PeachyPrinter/peachyprinterhardware1.0/README.md

# peachyprinterhardware1.0

All laser cut parts used in the $100 peachy printer kit

File types:

	- *.scad design files (OpenScad) 

	- *.dxf exported vector file 

	- *.smc after modified for lasercutting (SmartCarve)
