PeachyPrinter/peachyprinterhardware1.0/coil_circuit_jig.dxf

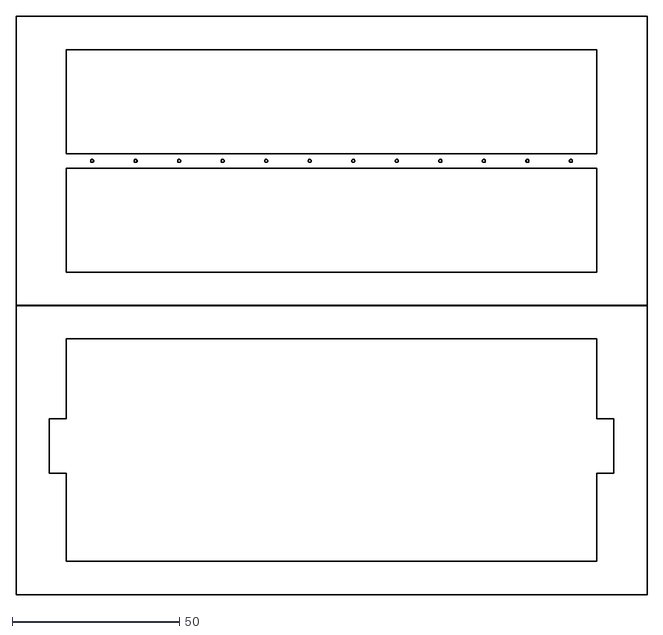
[picture p1: CAD file, 2015-10-30]
coil_circuit_jig.dxf
188.5 x 172.7
