PeachyPrinter/peachyprinterhardware1.0/tools/snaps.dxf

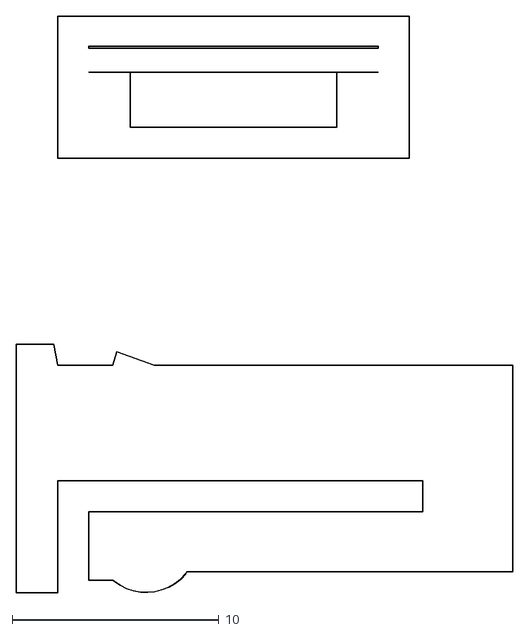
[picture p2: CAD file, 2015-04-24]
tools/snaps.dxf
24.0 x 27.9
