PeachyPrinter/peachyprinterhardware1.0/parts/hosePlug.dxf

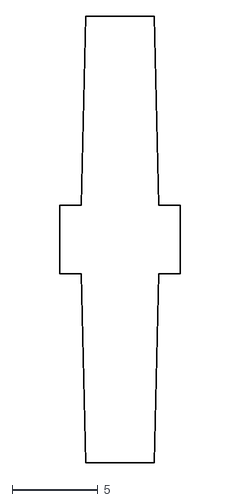
[picture p3: CAD file, 2015-12-13]
parts/hosePlug.dxf
7.00 x 26.0
