PeachyPrinter/peachyprinterhardware1.0/parts/hose_clamp.dxf

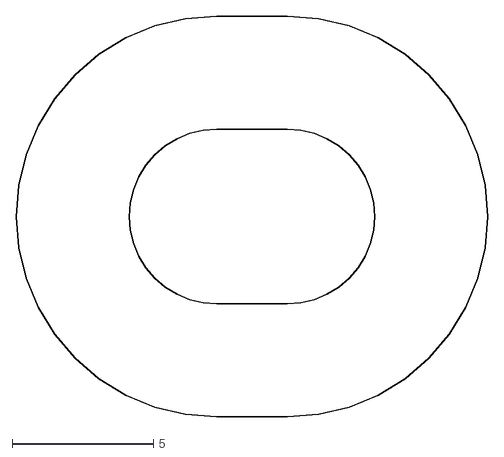
[picture p4: CAD file, 2015-12-13]
parts/hose_clamp.dxf
16.7 x 14.2
