PeachyPrinter/peachyprinterhardware1.0/parts/peachyScanner.dxf

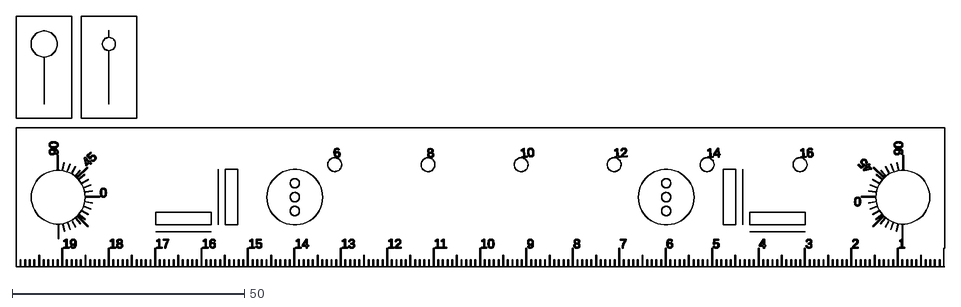
[picture p5: CAD file, 2015-12-05]
parts/peachyScanner.dxf
200.0 x 54.0
