PeachyPrinter/peachyprinterhardware1.0/parts/frame.dxf

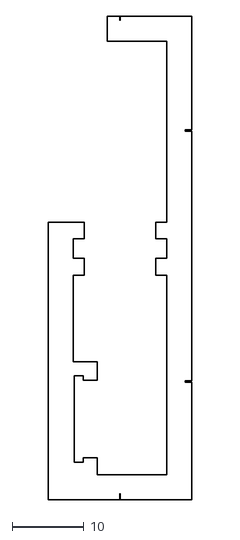
[picture p6: CAD file, 2015-10-30]
parts/frame.dxf
20.0 x 67.5
