PeachyPrinter/peachyprinterhardware1.0/parts/magnifying_glass_easter_egg.dxf

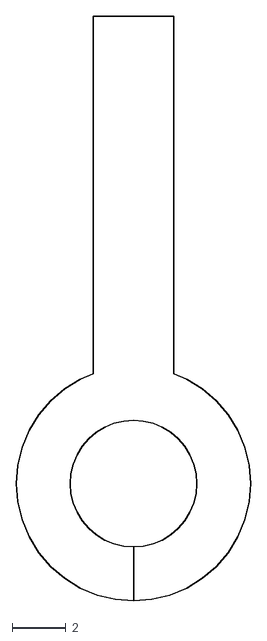
[picture p7: CAD file, 2015-10-30]
parts/magnifying_glass_easter_egg.dxf
8.70 x 21.7
