PeachyPrinter/peachyprinterhardware1.0/parts/mirror_easter_egg.dxf

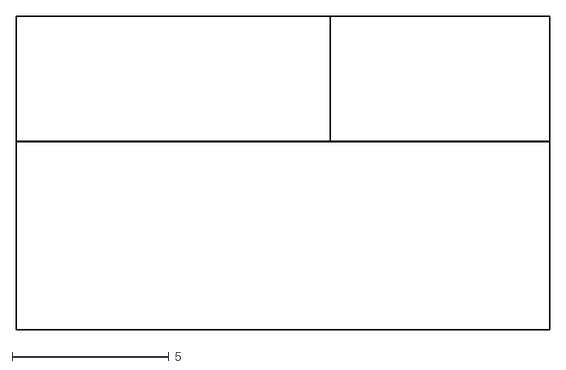
[picture p8: CAD file, 2015-10-14]
parts/mirror_easter_egg.dxf
17.0 x 10.0
