PeachyPrinter/peachyprinterhardware1.0/parts/galvo.dxf

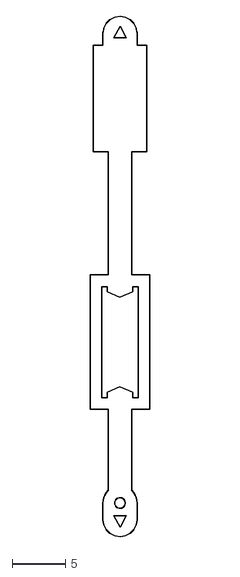
[picture p9: CAD file, 2015-09-26]
parts/galvo.dxf
5.60 x 48.8
