PeachyPrinter/peachyprinterhardware1.0/parts/circuitBrace2.dxf

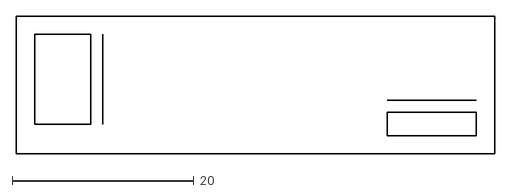
[picture p10: CAD file, 2015-08-28]
parts/circuitBrace2.dxf
52.7 x 15.2
