PeachyPrinter/peachyprinterhardware1.0/parts/circuitHolder.dxf

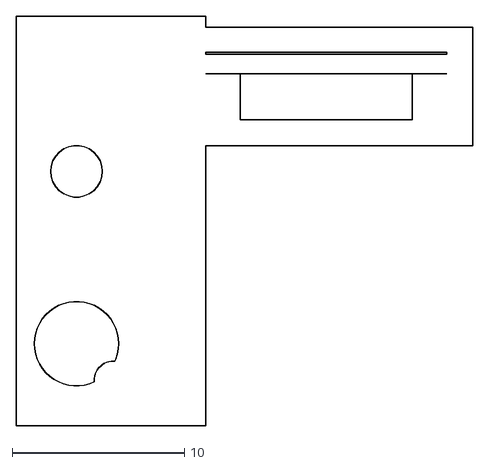
[picture p11: CAD file, 2015-08-28]
parts/circuitHolder.dxf
26.5 x 23.8
