PeachyPrinter/peachyprinterhardware1.0/parts/mirror.dxf

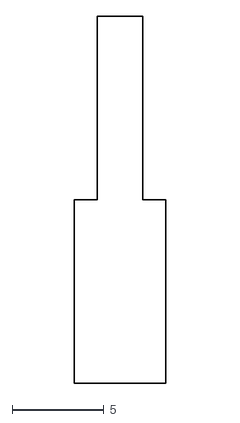
[picture p12: CAD file, 2015-08-11]
parts/mirror.dxf
5.00 x 20.0
