PeachyPrinter/peachyprinterhardware1.0/parts/circuitBrace.dxf

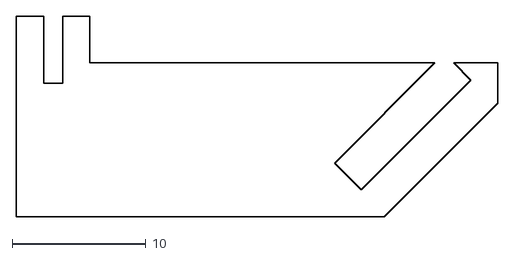
[picture p13: CAD file, 2015-07-31]
parts/circuitBrace.dxf
36.0 x 15.0
