PeachyPrinter/peachyprinterhardware1.0/parts/box.dxf

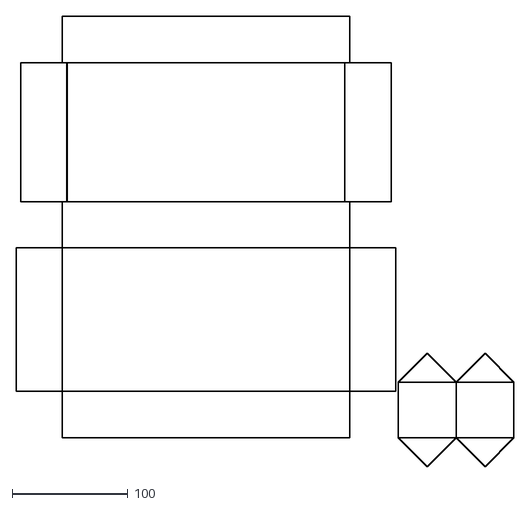
[picture p14: CAD file, 2015-06-11]
parts/box.dxf
430.0 x 389.0
