PeachyPrinter/peachyprinterhardware1.0/parts/magnetRing.dxf

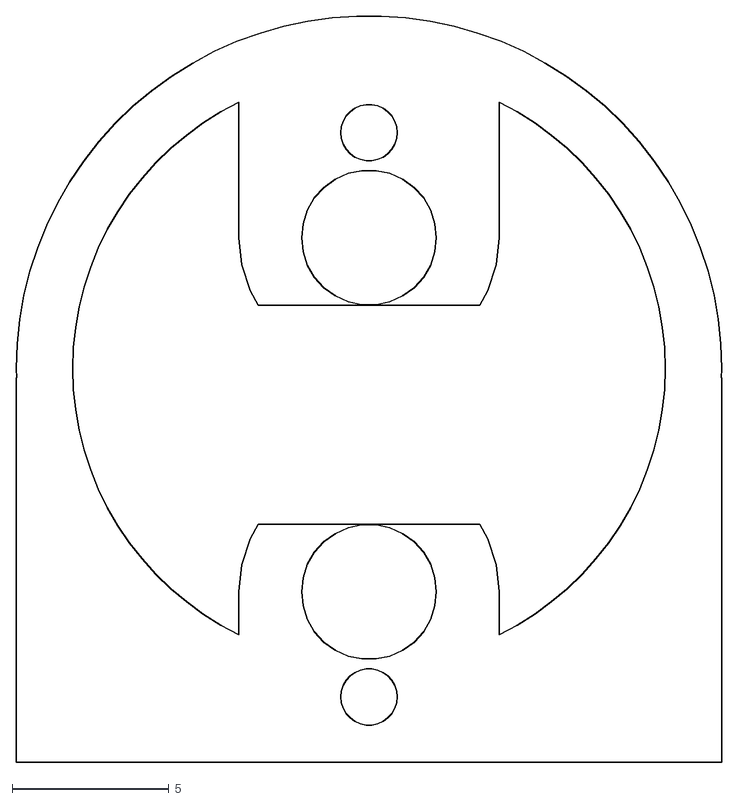
[picture p15: CAD file, 2015-05-21]
parts/magnetRing.dxf
22.5 x 23.8
