PeachyPrinter/peachyprinterhardware1.0/parts/hose_clamp.scad

dy=-.5;
dx=+.5;

r=7.2/2+dy;
d=1-dy*2+dx;
t=4;
$fn=40;

difference(){
    hoop(r+t,d);
    hoop(r,d);
}


module hoop(s,x){
    translate([-x/2,0]) circle(s);
    translate([-x/2,-s]) square([x,s*2]);
    translate([x/2,0]) circle(s);
    
}
