PeachyPrinter/peachyprinterhardware1.0/parts/magnifying_glass_easter_egg.scad

d=4.6;
r=d/2;
th=2;
t=0.01;
$fn=40;

handle=[3,15];

difference(){
    circle(r+th);
    circle(r);
    translate([0,-r-th])square([t,th]);
}
translate([-handle[0]/2,r]) square(handle);
