PeachyPrinter/peachyprinterhardware1.0/(list of files, cad)

Other CAD files:
tools/snaps.scad
parts/circuit brace.dxf
parts/old-parts.scad
