PeachyPrinter/peachyprinterhardware1.0/(commit log)

2015-04-24 current files
    [circuit brace.dxf, circuit brace.scad, circuitHolder.dxf, circuitHolder.scad, frame.dxf, frame.scad, galvo.dxf, galvo.scad]
2015-04-24 linked file
    [circuitHolder.scad]
2015-04-29 added drip sensor to parts
    [drip-sensor.dxf, drip-sensor.scad]
2015-04-29 test cut 1 - 2:10 each
2015-04-29 ziptie holes
2015-05-05 openscad tool for making lines
    workaround for making paths (normally unavailable in openscad)
    makes very thin triangles
    [line.scad]
2015-05-21 rounded acetate arrow edges
    magnet/thread hole corners were interfering with rotation, so made
    rounded edges
    [galvo.dxf, galvo.scad]
2015-05-21 made magnetRing 0.2mm tighter to frame
    there was not enough friction holding magnetRing in place, so made it
    tighter
    [magnetRing.dxf, magnetRing.scad]
2015-05-21 moved coil away
    coil was too close and rubbing so moved away 0.5mm
    [frame.dxf, frame.scad]
2015-05-21 shortened coil holders
    [frame.dxf, frame.scad]
2015-05-27 extra brace for circuit by usb connection
    [circuitBrace.scad, circuitBrace2.dxf, circuitBrace2.scad]
2015-05-31 larger source hose
    [drip-sensor.scad]
2015-06-01 source hose even larger
    [drip-sensor.scad]
2015-06-11 re-parameterized box
    [box.dxf, box.scad]
2015-07-30 allowed for burr on aluminum edges
    [galvo.scad]
2015-07-30 moved back circuit mount on T
    (for laser mount modification) (not changed on parts plate yet)
2015-07-31 made circuit braces work with new circuit position
    [circuitBrace.dxf, circuitBrace.scad, circuitBrace2.dxf, circuitBrace2.scad]
2015-07-31 sized to fit hand shaped aluminum piece
    [galvo.dxf, galvo.scad]
2015-08-11 triangle aluminum rod holder
    [galvo.dxf, galvo.scad]
2015-08-11 mirror with scratchable area
    [mirror.dxf, mirror.scad]
2015-08-11 larger scratch area
    [mirror.dxf, mirror.scad]
2015-08-11 strengthen dripper
    using wider hose -> dripper can be larger
    [drip-sensor.dxf, drip-sensor.scad]
2015-08-11 even thicker
    [drip-sensor.scad]
2015-08-11 wallthickness bug
    [drip-sensor.dxf, drip-sensor.scad]
2015-08-11 strengthen weak point
    [drip-sensor.dxf, drip-sensor.scad]
2015-08-11 more gap to left and right
    [drip-sensor.dxf, drip-sensor.scad]
2015-08-11 long scratch area
    [mirror.dxf, mirror.scad]
2015-08-12 separated BFrameHolder from old files
    [BFrameHolder.scad]
2015-08-14 added pole for intake hose to slide onto
    needed to restrict flow to get better drip control, added benefit of
    holding the hose nicely
    [drip-sensor.dxf, drip-sensor.scad]
2015-08-16 tested size of hosePoke
    [drip-sensor.dxf, drip-sensor.scad]
2015-08-17 added markings on parts plate
    added markings and made stamp parts
2015-08-17 Revert "dxf"
    This reverts commit 69d13f8da8462a6627d4cfdbc5b04114a3d9410c.
    [galvo.dxf]
2015-08-17 Revert "triangle aluminum rod holder"
    This reverts commit 434e96d71800452a7b50f8de4a87a5867f8644ad.
    [galvo.dxf, galvo.scad]
2015-08-17 added lego holes
2015-08-20 fix weak points, arrow direction, frame fit
2015-08-20 mirror brace, fix T circuit point
2015-08-20 drip gap from 7 to 8.5
    drips were possibly double counting
    [drip-sensor.scad]
2015-08-20 diode jig holes
2015-08-20 weak point
    [drip-sensor.dxf]
2015-08-20 lego hole +.1xmm
2015-08-21 lego hole +.1
2015-08-21 frame arrow fix
2015-08-22 edge sharing between 2 parts plates
2015-08-28 make circuit holder fit laser plug tightly
    [circuitHolder.scad]
2015-08-28 remove second screw hole
    [circuitHolder.scad]
2015-08-28 convert square "one" to be center
    [circuitBrace2.scad]
2015-08-28 add flexture
    [circuitBrace2.dxf, circuitBrace2.scad]
2015-08-28 usb mount is large part of cable
    [circuitBrace2.scad]
2015-08-28 fixed conversion to center, fitted
    [circuitBrace2.dxf, circuitBrace2.scad]
2015-09-26 Revert "Revert "triangle aluminum rod holder""
    This reverts commit eee4854521fbf78fe7e41c1fa86e9b44c0f74e4d.
    [galvo.dxf, galvo.scad]
2015-09-26 re-implement triangle galvo, base sized
    [galvo.dxf, galvo.scad]
2015-09-26 slower speed
    (50% total time), now 20 mm/s
2015-09-30 styrofoam dividers for box
    [foam_packaging.scad]
2015-09-30 version 2
    [foam_packaging.scad]
2015-10-07 galvo Al length -.1mm
    [galvo.scad]
2015-10-07 frame notches further, rotated
    [frame.dxf, frame.scad]
2015-10-07 frame notch rotation switched, widened
    [frame.dxf, frame.scad]
2015-10-14 moved from slotting pieces to stacking
    [foam_packaging.scad]
2015-10-14 fractional inches
    [foam_packaging.scad]
2015-10-14 easter egg mirror part
    [mirror_easter_egg.scad]
2015-10-14 hose shutoff
    kinks hose to stop flow
    [hose_clamp.scad]
2015-10-14 magnifying glass easter egg part
    [magnifying_glass_easter_egg.scad]
2015-10-21 added a file to record laser settings used when cutting varius peachy parts"
2015-10-30 dxf and moving
    [hose_clamp.dxf, magnifying_glass_easter_egg.dxf, magnifying_glass_easter_egg.scad, mirror_easter_egg.scad]
2015-10-30 actually seals (so far)
    [hose_clamp.scad]
2015-10-30 hold lens not brass
    [magnifying_glass_easter_egg.scad]
2015-10-30 cleaned lens, cuts faster
2015-10-30 jig for gluing/soldering coils onto a circuit board
    [coil_circuit_jig.dxf, coil_circuit_jig.scad]
2015-10-30 allowed circuit board coil to attach to frame
    [frame.dxf, frame.scad]
2015-10-30 parts plates update
2015-11-23 change default to length 0, usage description
    [line.scad]
2015-11-23 add example
    [line.scad]
2015-11-27 laser Scanner/ Ruler
    [peachyScanner.scad]
2015-11-28 break into 2
    [peachyScanner.scad]
2015-11-28 laser and laserline for second half
    [peachyScanner.scad]
2015-12-04 added a tray intended to hold acrilic rod during laser cuting it into pices to be used as line laser lenses
    [laserLineLensTray.scad]
2015-12-05 laser files
    [peachyScanner.dxf]
2015-12-06 laser cutting
2015-12-06 cut 100 line lens
    [laserLineLensTray.scad, peachyScanner.scad]
2015-12-13 plug for smaller air bubbles
    [hosePlug.dxf, hosePlug.scad]
2015-12-13 small changes
    [hose_clamp.dxf, hose_clamp.scad]
2015-12-13 Smaller bubbles hopefully
    [hosePlug.dxf, hosePlug.scad]
2015-12-13 stronger, removed extra holes (in .smc)
    [drip-sensor.dxf, drip-sensor.scad]
2015-12-13 4 hole bottle cap
2015-12-14 hole for aperture ring
2015-12-16 removed aperture from plate
2015-12-16 drip gap +0.5mm, holes cut nicer. Second version has wider hose grab
2015-12-17 prototype spool winder for scanner
2015-12-17 drip gap +1.5mm
2015-12-18 foam longer laser lead
2015-12-19 mirror for webcam to see encoder disk
2015-12-20 larger scanner laser base, fix scanner holder
2015-12-21 test piece, lego flex, scanner circuit mount, red laser pivot
2015-12-22 red laser wire holes: 2 on each side
2015-12-22 cut lines
2015-12-22 armatures clear circuit board better
2015-12-22 split up plates
2015-12-24 cut for 15 kits
2017-04-18 explained snap1
    [snap1.scad]
