PeachyPrinter/peachyprinterhardware1.0/parts/drip-sensor.dxf

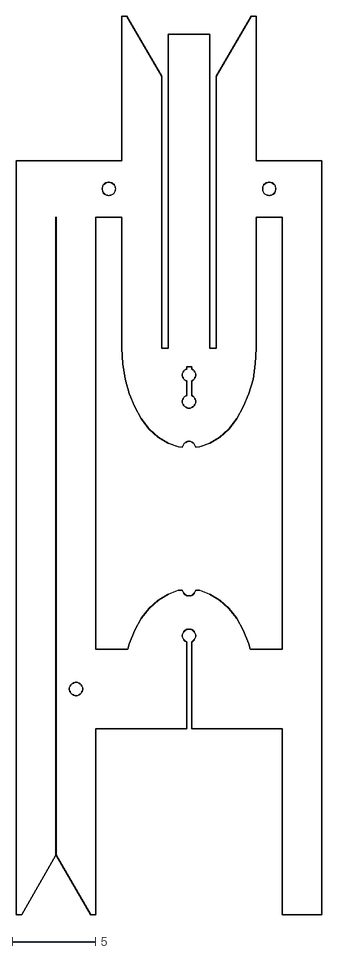
[picture p1: CAD file, 2015-12-13]
parts/drip-sensor.dxf
18.4 x 54.1
